ersatzavian/planespotter/images/ping.JPG

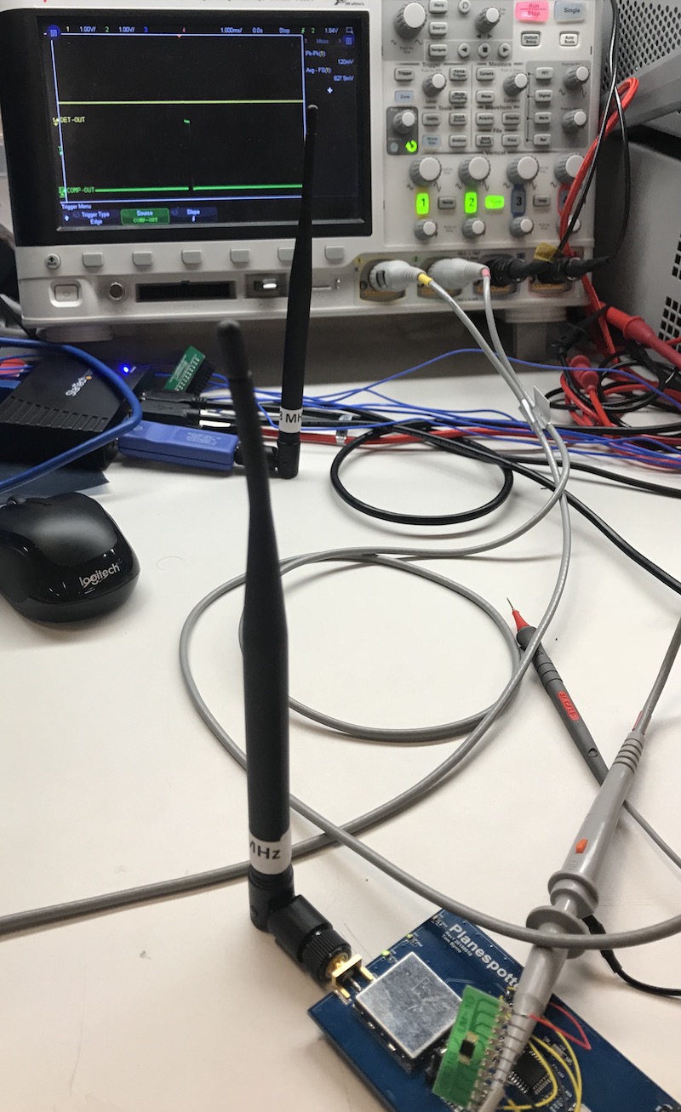
images/ping.JPG
