ersatzavian/planespotter/(list of files, drawings)

Other design files:
hardware/planespotter.PcbDoc
hardware/planespotter.PrjPCB
hardware/planespotter.SchDoc
