ersatzavian/planespotter/software/planespotter_blink/Core/Src/main.c

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
/* Includes ------------------------------------------------------------------*/
#include "main.h"


void SystemClock_Config(void);
static void MX_GPIO_Init(void);
/**
  * @brief  The application entry point.
  * @retval int
  */
int main(void)
{

  /* USER CODE BEGIN 1 */

  char ledState1 = 1;
  char ledState2 = 0;
  char ledState3 = 1;

  /* USER CODE END 1 */

  /* MCU Configuration--------------------------------------------------------*/

  /* Reset of all peripherals, Initializes the Flash interface and the Systick. */
  HAL_Init();

  /* Configure the system clock */
  SystemClock_Config();

  /* Initialize all configured peripherals */
  MX_GPIO_Init();
  /* USER CODE BEGIN 2 */

  HAL_GPIO_WritePin(GPIOB, GPIO_PIN_5, ledState1);
  HAL_GPIO_WritePin(GPIOB, GPIO_PIN_6, ledState2);
  HAL_GPIO_WritePin(GPIOB, GPIO_PIN_7, ledState3);

  /* USER CODE END 2 */

  /* Infinite loop */
  /* USER CODE BEGIN WHILE */
  while (1)
  {
    /* USER CODE END WHILE */

    /* USER CODE BEGIN 3 */
	ledState1 = 1 - ledState1;
	ledState2 = 1 - ledState2;
	ledState3 = 1 - ledState3;
	HAL_GPIO_WritePin(GPIOB, GPIO_PIN_5, ledState1);
	HAL_GPIO_WritePin(GPIOB, GPIO_PIN_6, ledState2);
	HAL_GPIO_WritePin(GPIOB, GPIO_PIN_7, ledState3);
	HAL_Delay(250);
  }
  /* USER CODE END 3 */
}

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
