ersatzavian/planespotter/(commit log)

2021-01-12 moved from hw-tom repo
    [planespotter-bom-rev1-20150610.xls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]
2024-10-28 got blinky working with STM32CubeIDE, adding notes
