ersatzavian/planespotter/(notices)

Notices in the files:
software/stm32loader.py:
stm32loader is free software; you can redistribute it and/or modify it under
the terms of the GNU General Public License as published by the Free
software/planespotter_blink/Core/Src/main.c:
Copyright (c) 2024 STMicroelectronics.
All rights reserved.
This software is licensed under terms that can be found in the LICENSE file
